oxullo/mml/eagle/production_files/revision_a/mml_matrix v14_top_bom.csv

Comment | Designator | Footprint | LCSC Part #
WS2812B-2020 | U101 U102 U103 U104 U105 U106 U107 U108 U109 U110 U111 U112 U113 U114 U115 U116 U117 U118 U119 U120 U121 U122 U123 U124 U125 U126 U127 U128 U129 U130 U131 U132 U133 U134 U135 U136 U137 U138 U139 U140 U141 U142 U143 U144 U145 U146 U147 U148 U149 U150 U151 U152 U153 U154 U155 U156 U157 U158 U159 U160 U161 U162 U163 U164 | RESCAV100P200X220X28-4L
