oxullo/mml/eagle/production_files/revision_b/mml_mcu_brd.pdf

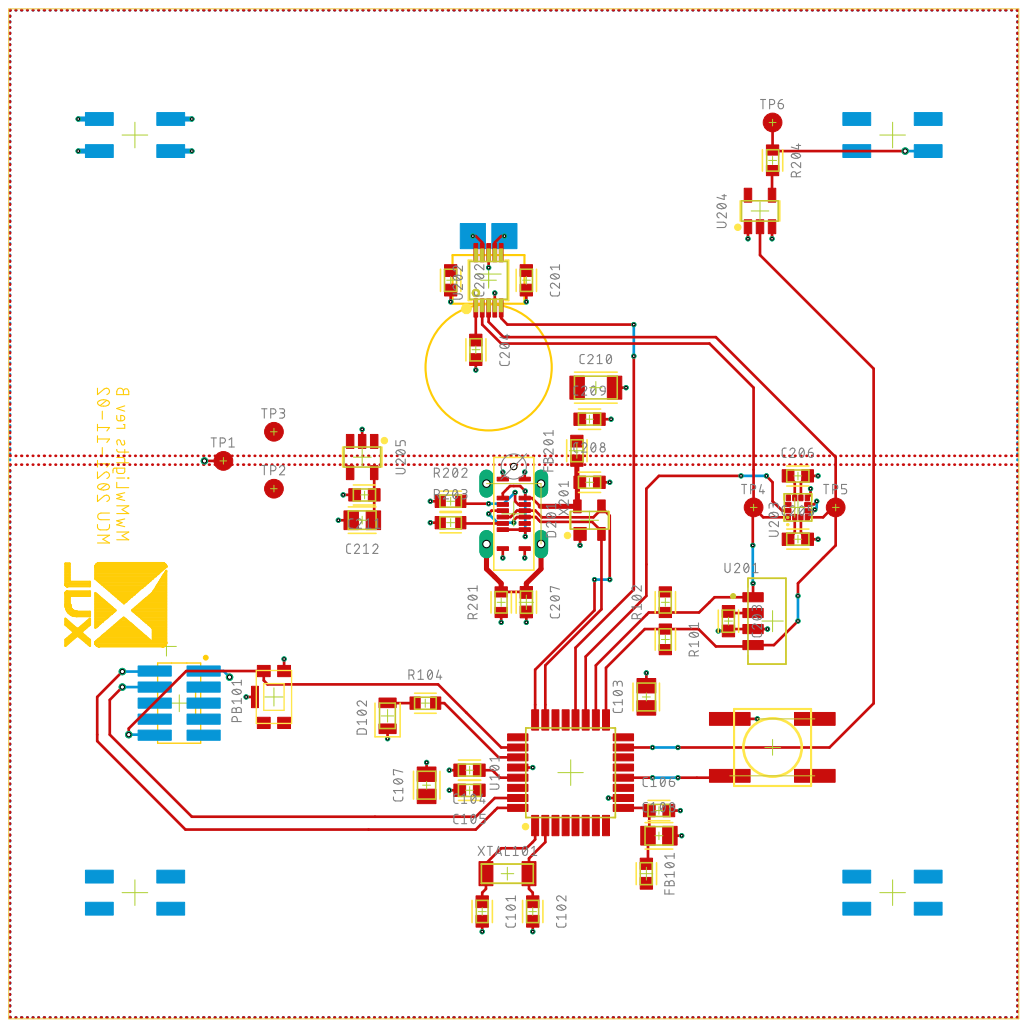
[picture p1: page 1]
