oxullo/mml/eagle/production_files/revision_b/mml_mcu_sch.pdf

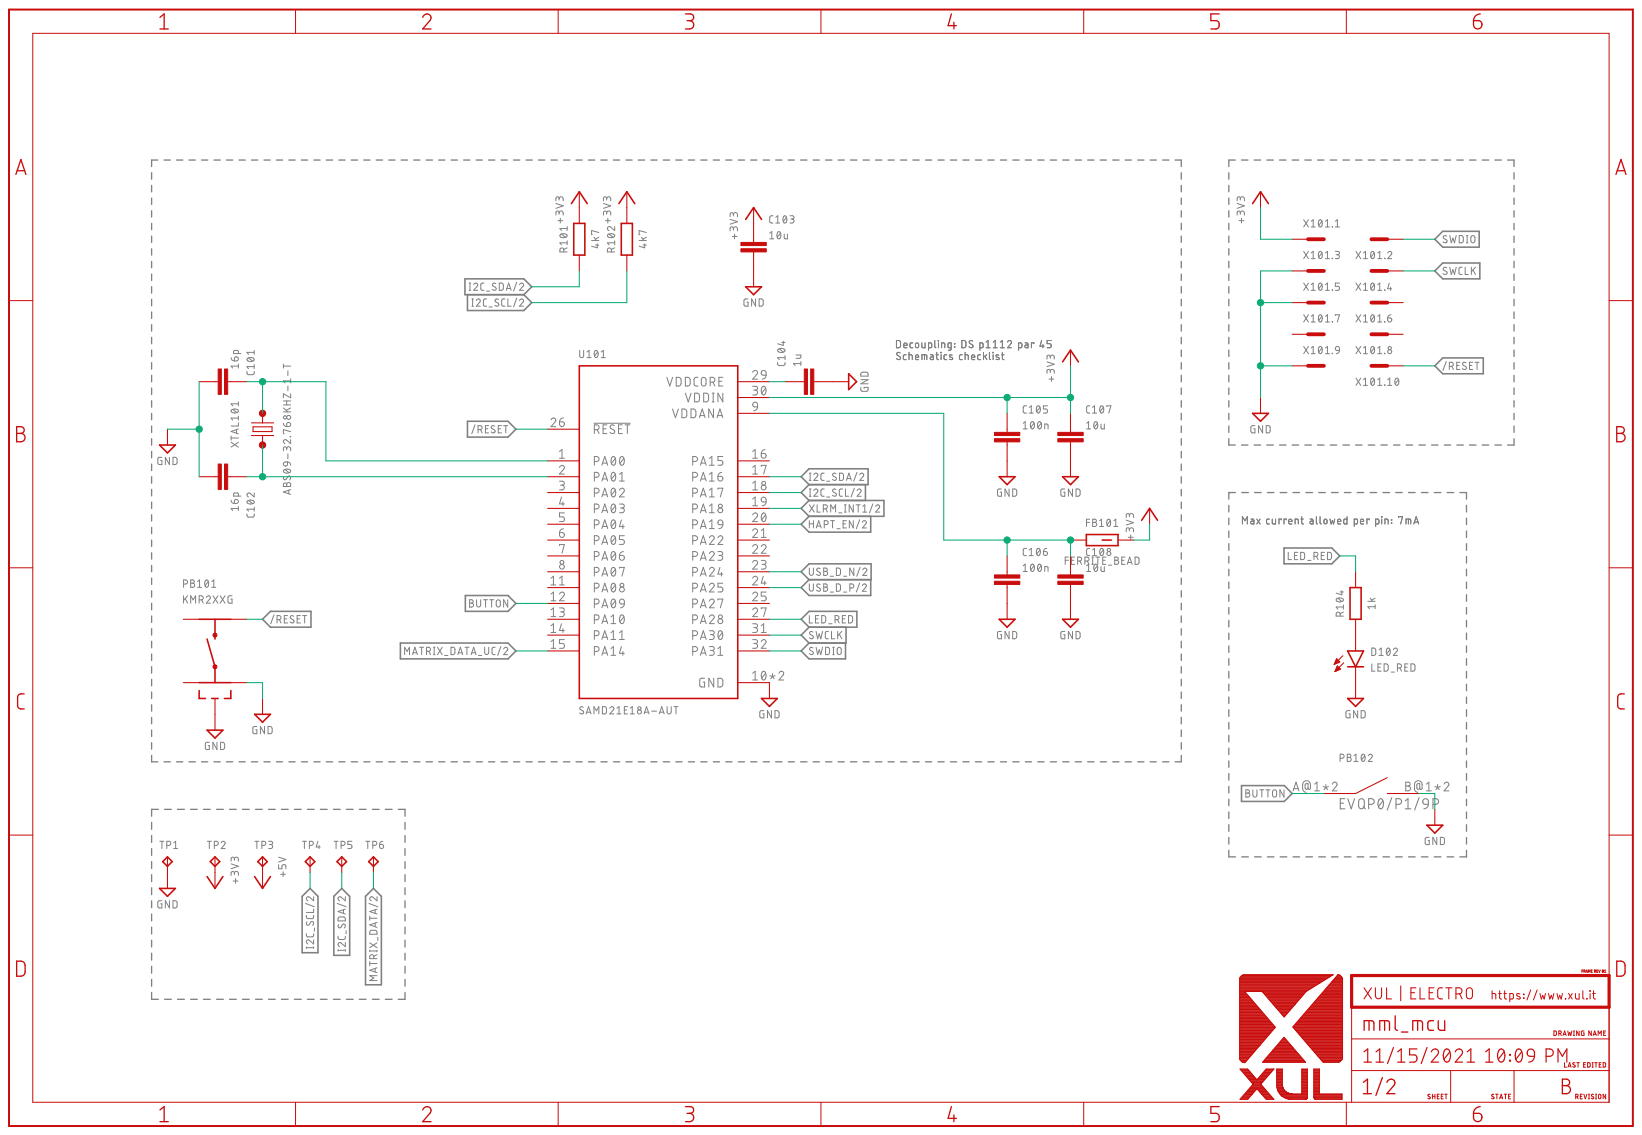
[picture p2: page 1]

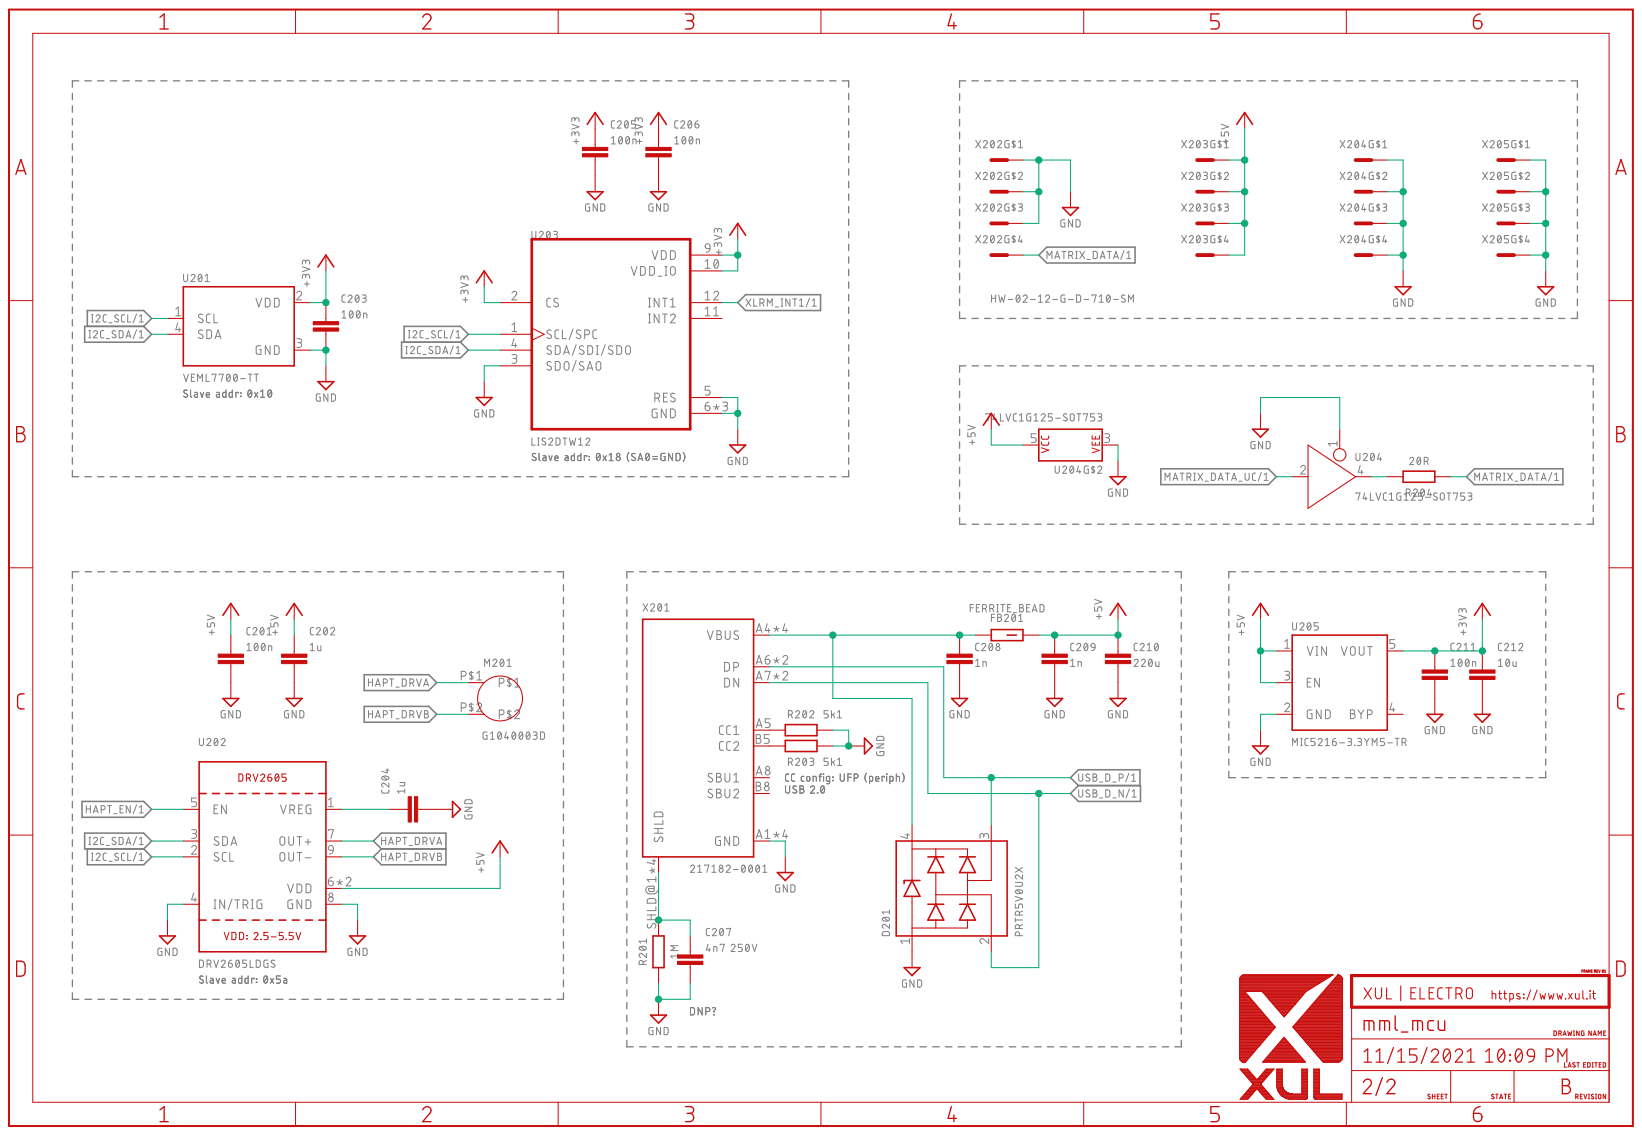
[picture p3: page 2]
