oxullo/mml/eagle/production_files/revision_a/mml_matrix_brd.pdf

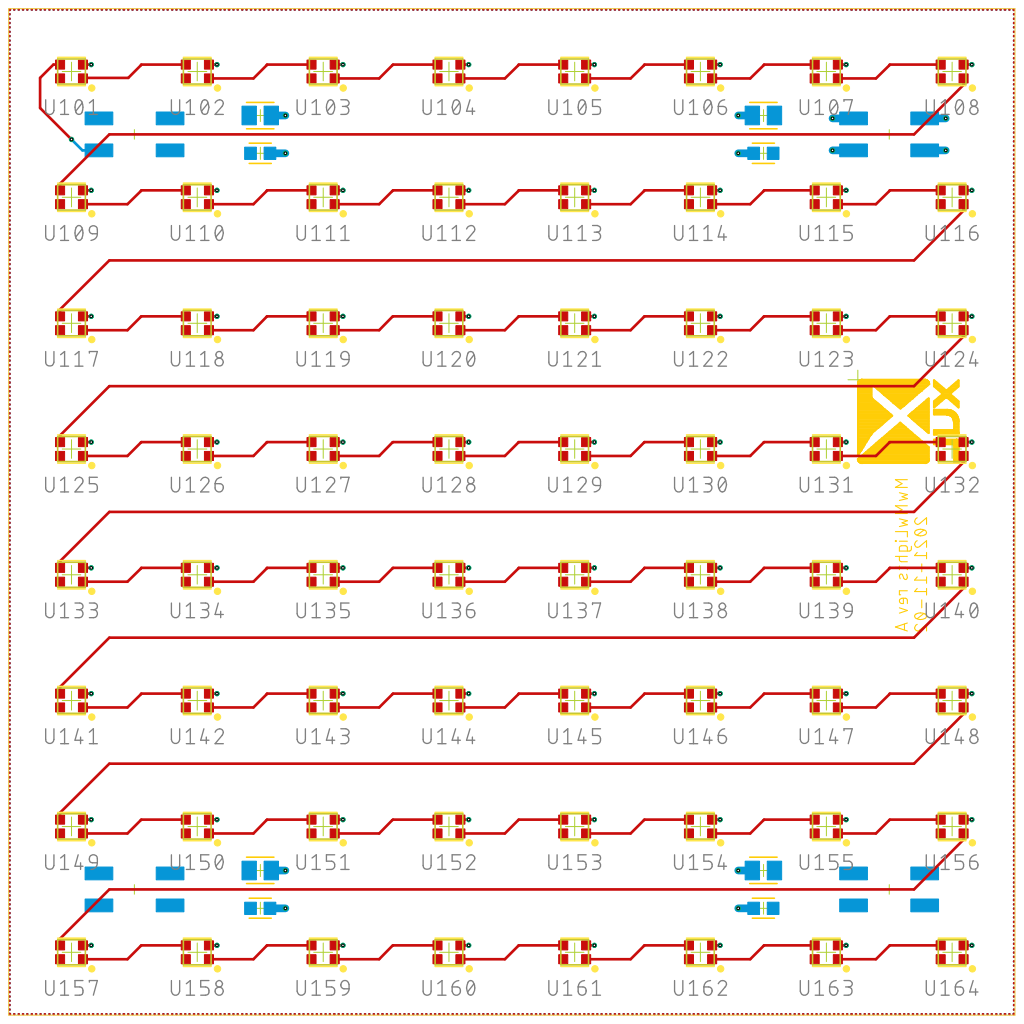
[picture p4: page 1]
