oxullo/mml/eagle/production_files/revision_a/mml_matrix_sch.pdf

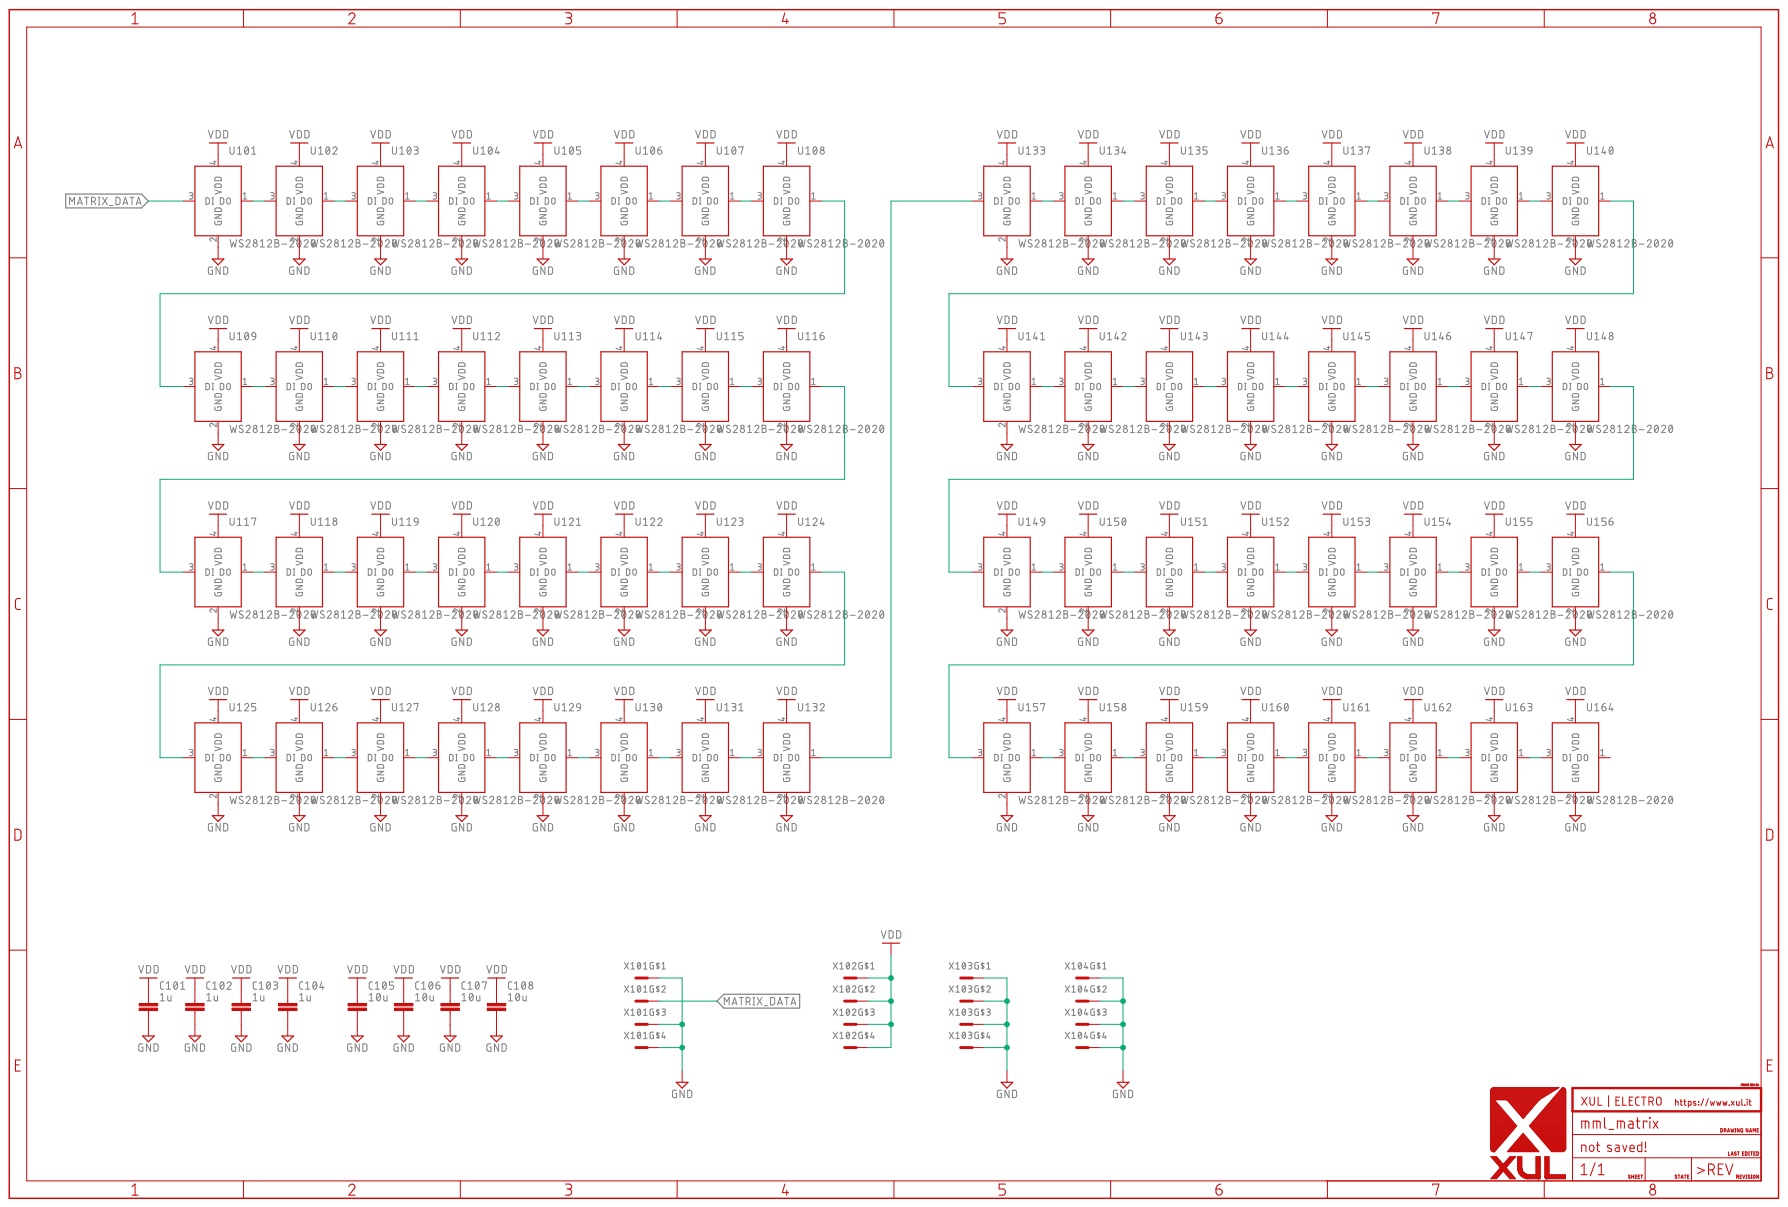
[picture p5: page 1]
