oxullo/mml/eagle/production_files/revision_a/mml_mcu_brd.pdf

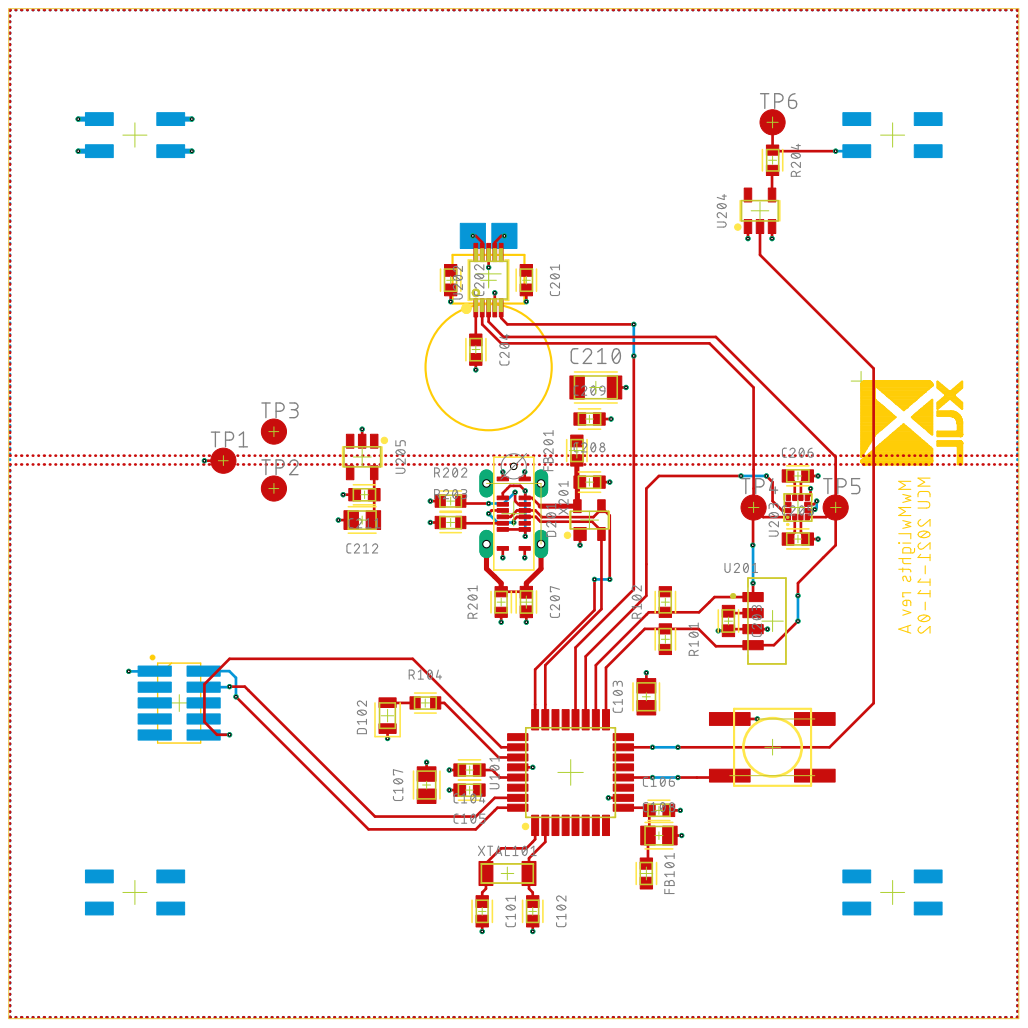
[picture p6: page 1]
