oxullo/mml/eagle/production_files/revision_a/mml_mcu_sch.pdf

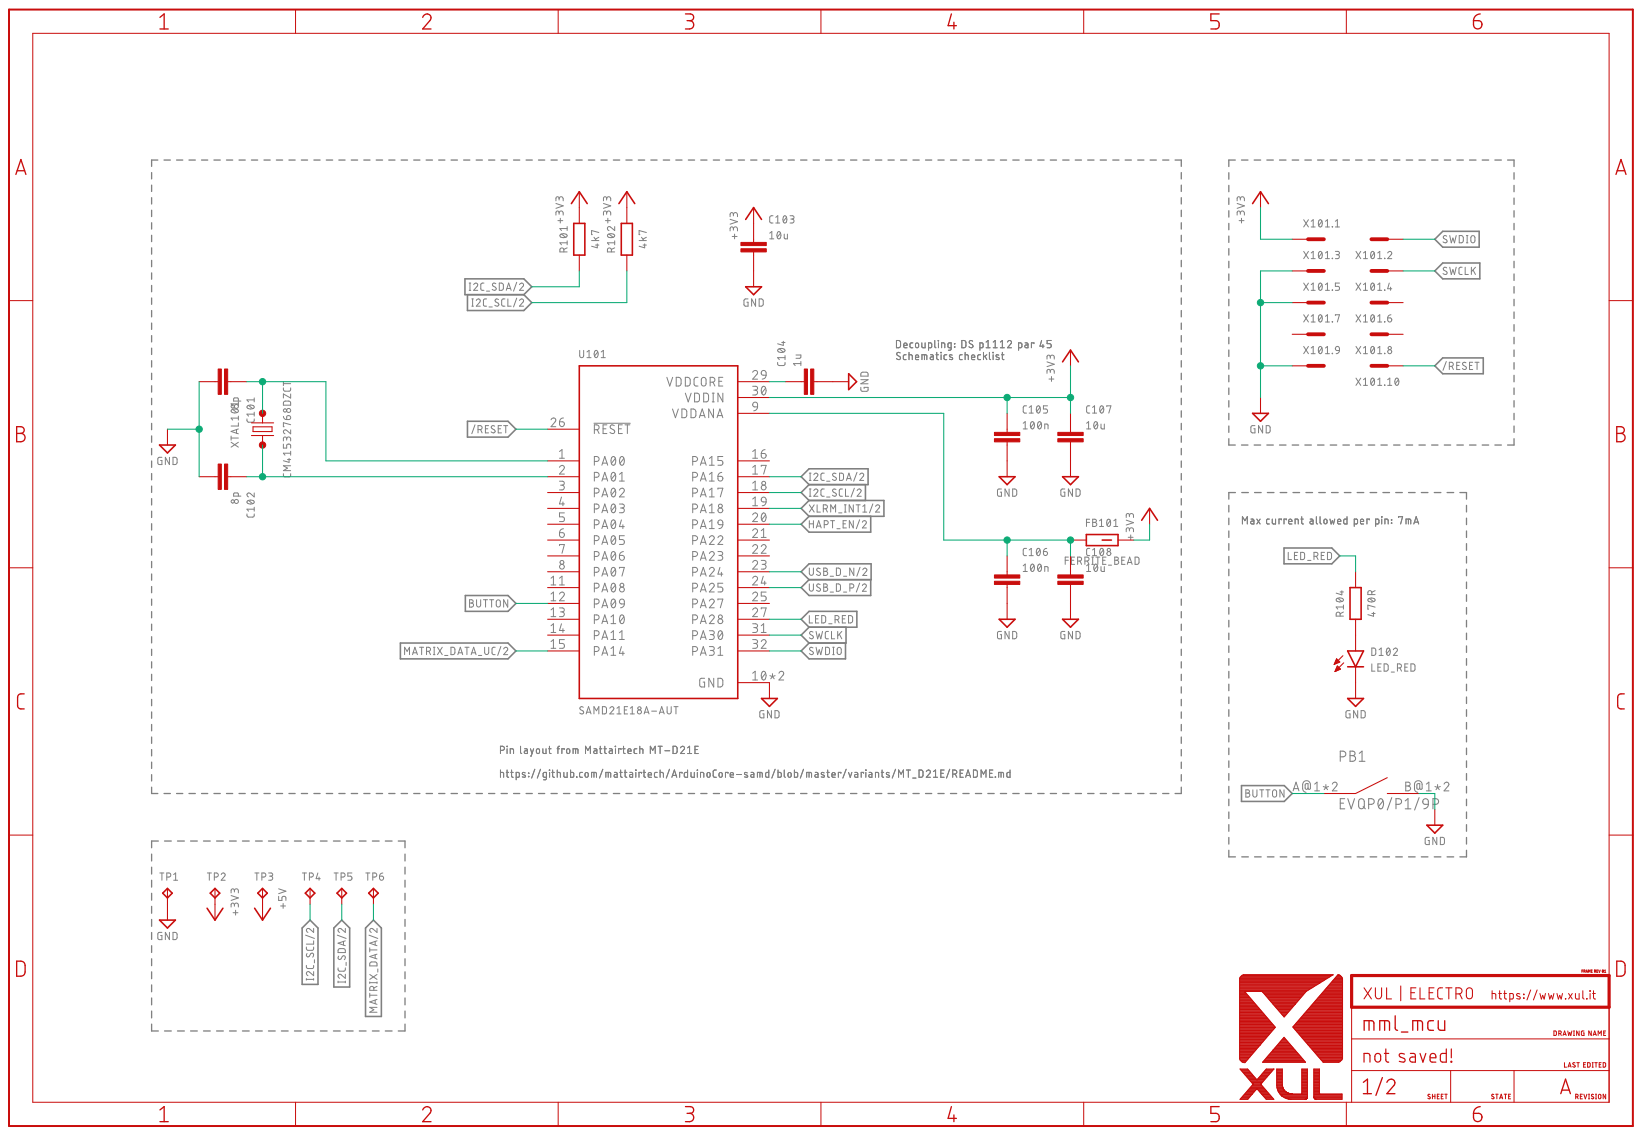
[picture p7: page 1]

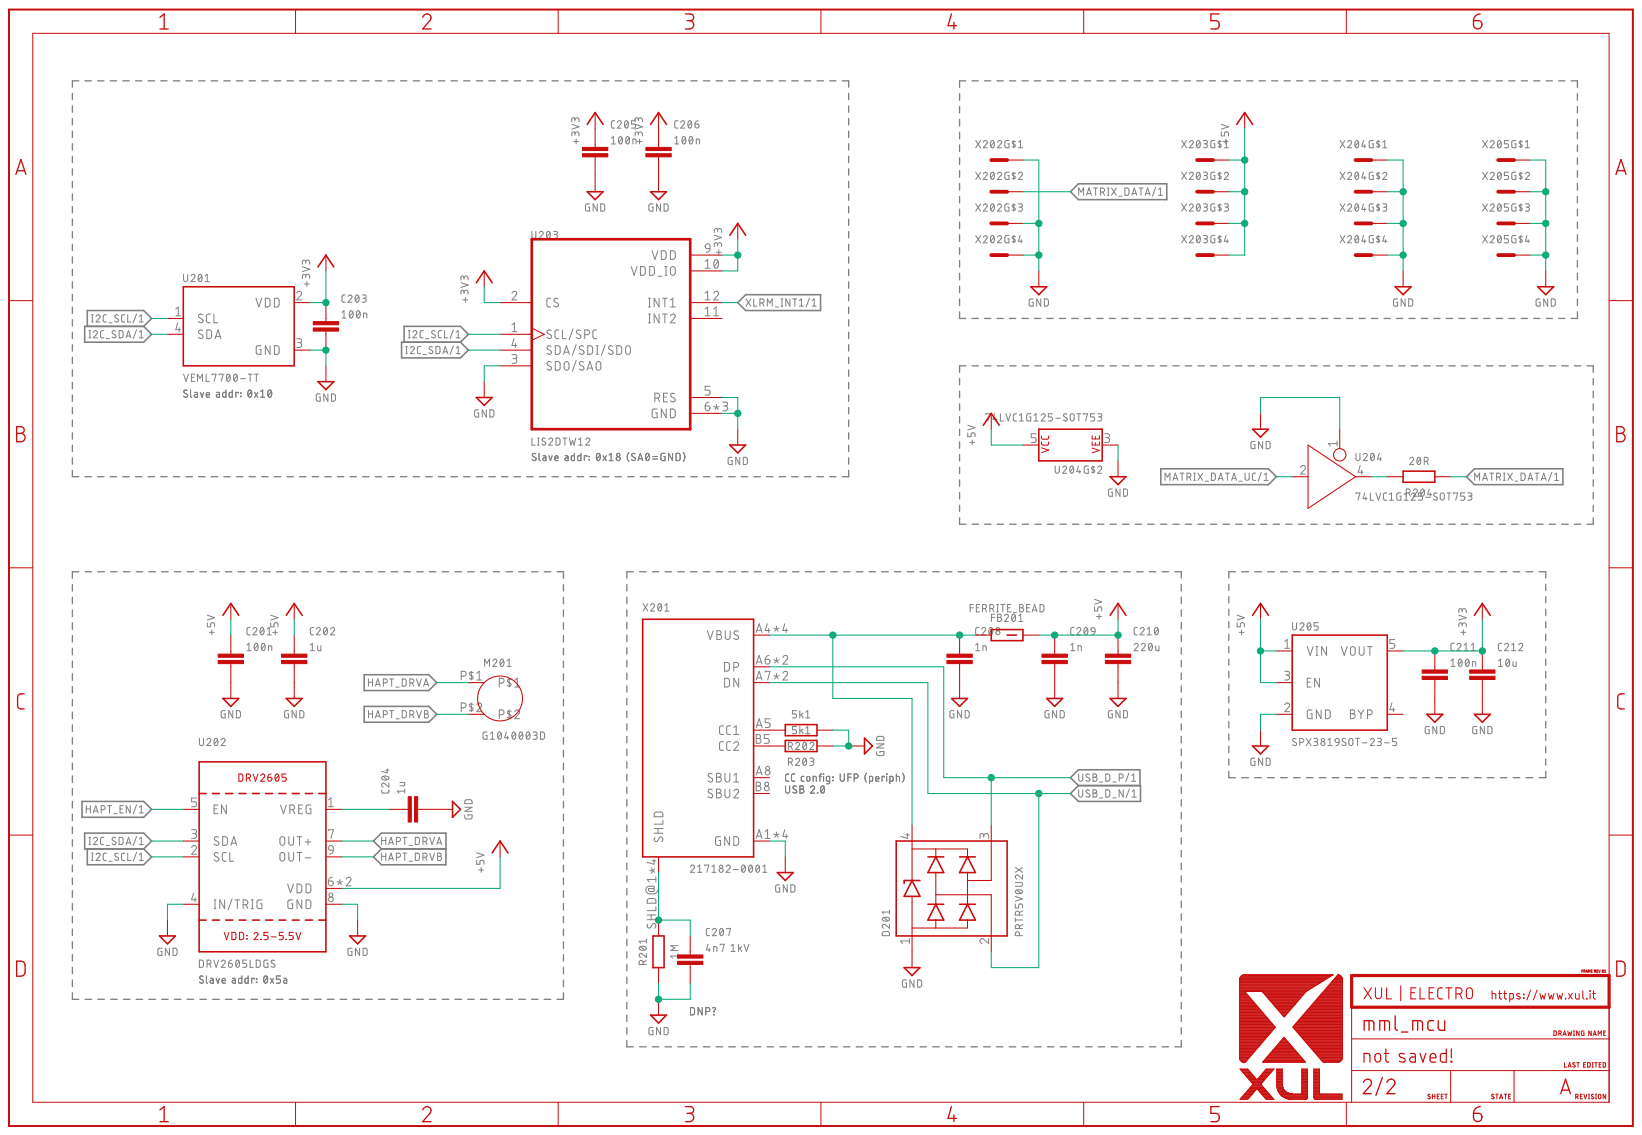
[picture p8: page 2]
