oxullo/mml/eagle/mml_mcu.brd

## EAGLE design eagle/mml_mcu.brd (2021-11-15)

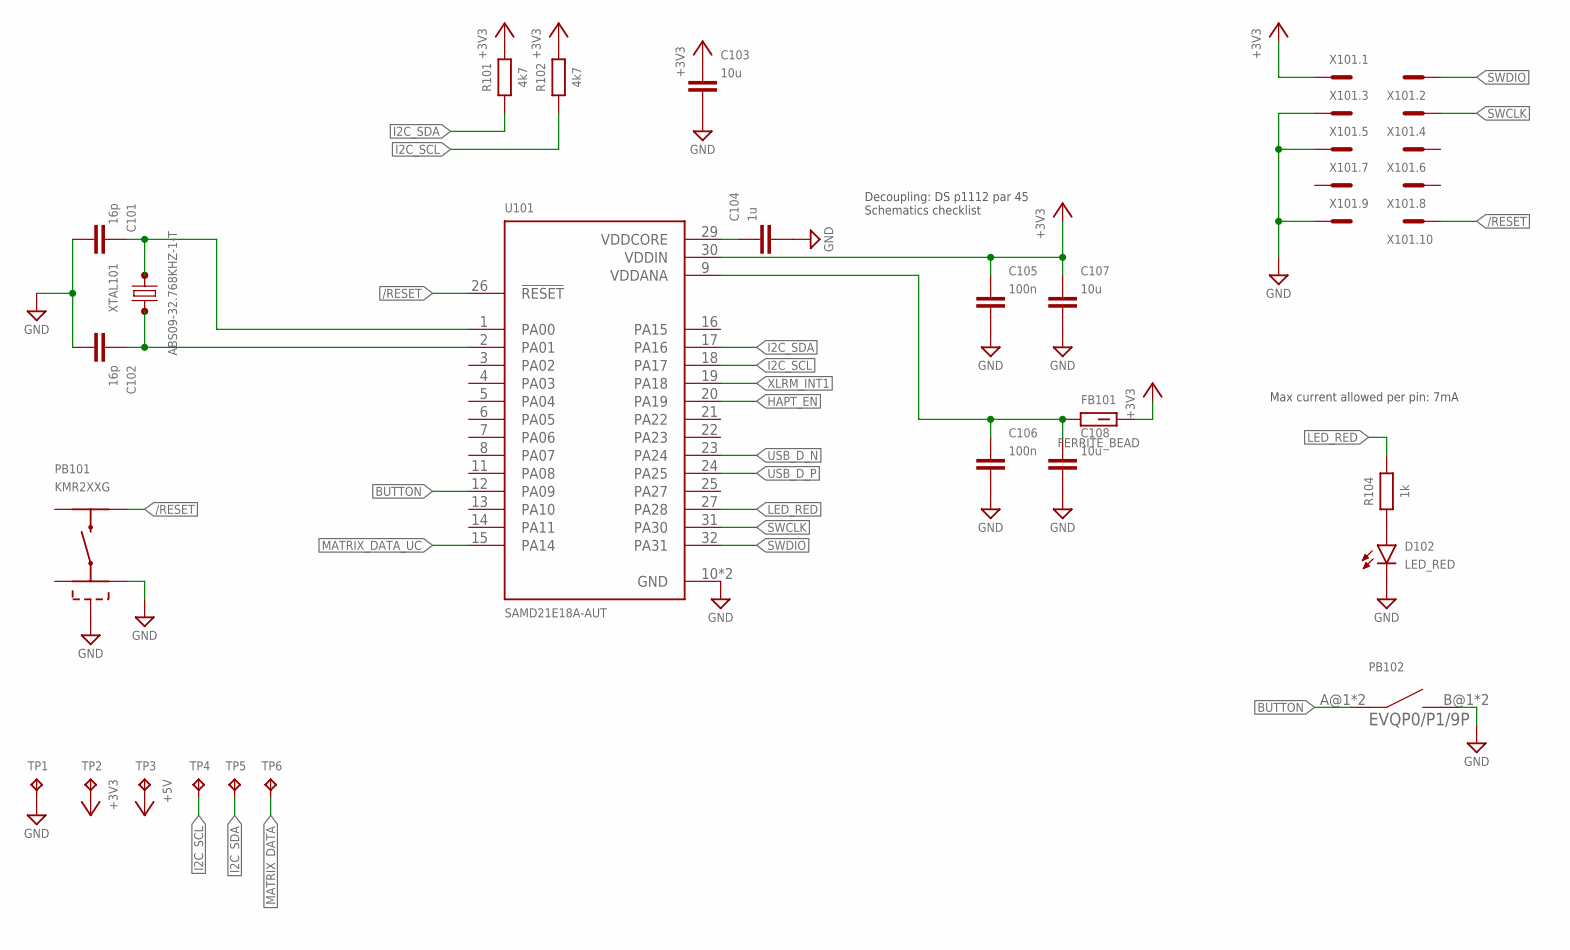
[picture p9: schematic mml_mcu.sch, sheet 1]

Parts:
C101, C102: 16p; CAPC1608X85
C103, C107, C108: 10u; CAPC2012X110
C104: 1u; CAPC1608X85
C105, C106: 100n; CAPC1608X85
D102: LED_RED; LEDC2012X110N_FLAT-R
FB101: FERRITE_BEAD; BEADC1608X95N
PB101: KMR2XXG
PB102: EVQP0/P1/9P
R101, R102: 4k7; RESC1608X60
R104: 1k; RESC1608X60
TP1, TP2, TP3, TP4, TP5, TP6: TPTP15R; TP15R
U101: SAMD21E18A-AUT; QFP80P900X900X120-32N
X101: M50-3600542R
XTAL101: ABS09-32.768KHZ-1-T; XTAL410X150X90

Connections:
+3V3: C103.1, C105.1, C107.1, FB101.2, R101.2, R102.2, TP2.TP, U101.30 (VDDIN), X101.1; also elsewhere on the board
+5V: TP3.TP; also elsewhere on the board
/RESET: PB101.1, U101.26 (!RESET), X101.10
BUTTON: PB102.A@1 (A), PB102.A@2 (A), U101.12 (PA09)
GND: C101.2, C102.2, C103.2, C104.2, C105.2, C106.2, C107.2, C108.2, D102.C, PB101.2, PB101.5, PB102.B@1 (B), PB102.B@2 (B), TP1.TP, U101.10 (GND), U101.28 (GND), X101.3, X101.5, X101.9; also elsewhere on the board
HAPT_EN: U101.20 (PA19); also elsewhere on the board
I2C_SCL: R102.1, TP4.TP, U101.18 (PA17); also elsewhere on the board
I2C_SDA: R101.1, TP5.TP, U101.17 (PA16); also elsewhere on the board
LED_RED: R104.2, U101.27 (PA28)
MATRIX_DATA: TP6.TP; also elsewhere on the board
MATRIX_DATA_UC: U101.15 (PA14); also elsewhere on the board
unnamed: C101.1, U101.1 (PA00), XTAL101.1 (A)
unnamed: C102.1, U101.2 (PA01), XTAL101.2 (B)
unnamed: C104.1, U101.29 (VDDCORE)
unnamed: D102.A, R104.1
unnamed: C106.1, C108.1, FB101.1, U101.9 (VDDANA)
SWCLK: U101.31 (PA30), X101.4
SWDIO: U101.32 (PA31), X101.2
USB_D_N: U101.23 (PA24); also elsewhere on the board
USB_D_P: U101.24 (PA25); also elsewhere on the board
XLRM_INT1: U101.19 (PA18); also elsewhere on the board

Notes on the sheet:
Decoupling: DS p1112 par 45 Schematics checklist
Max current allowed per pin: 7mA

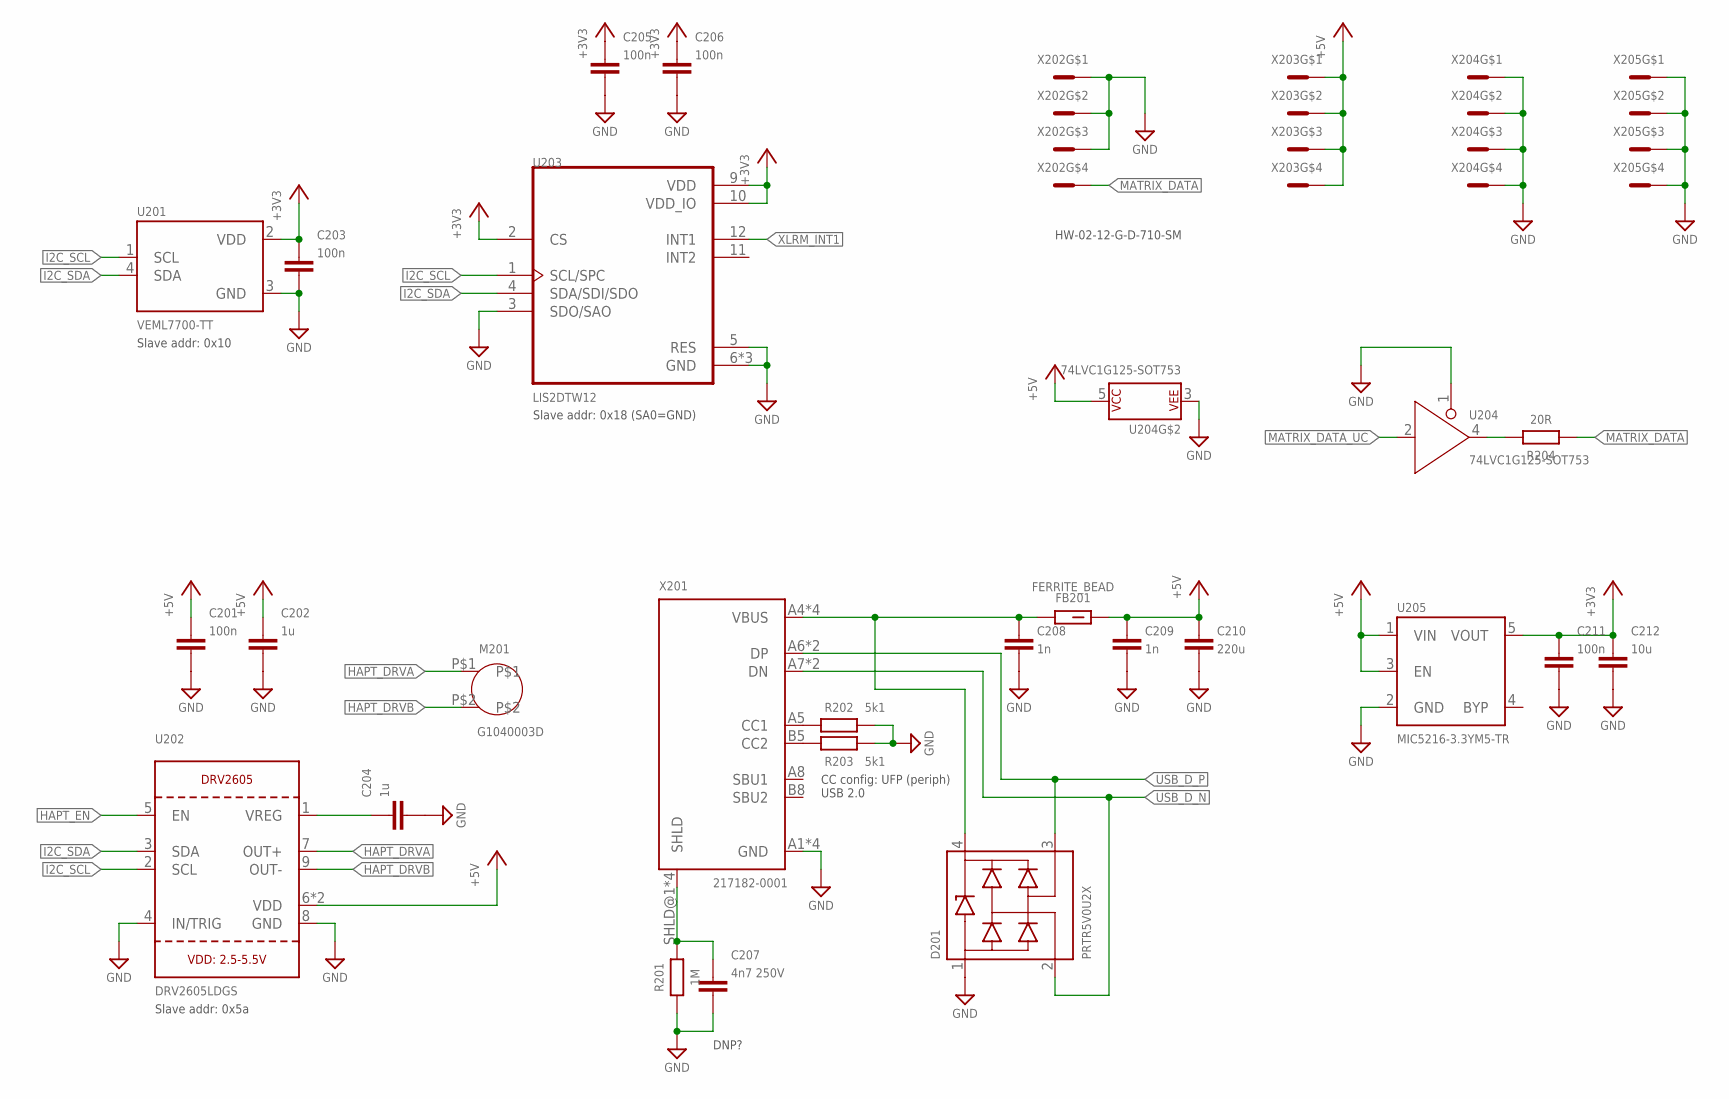
[picture p10: schematic mml_mcu.sch, sheet 2]

Parts:
C201, C203, C205, C206, C211: 100n; CAPC1608X85
C202, C204: 1u; CAPC1608X85
C207: 4n7 250V; CAPC1608X85
C208, C209: 1n; CAPC1608X85
C210: 220u; CAPC3216X135
C212: 10u; CAPC2012X110
D201: PRTR5V0U2X; SOT190P230X110-4N
FB201: FERRITE_BEAD; BEADC1608X95N
M201: G1040003D
R201: 1M; RESC1608X60
R202, R203: 5k1; RESC1608X60
R204: 20R; RESC1608X60
U201: VEML7700-TT; XDCR_VEML7700-TT
U202: DRV2605LDGS; PSOP10; LCSC_PART C527464
U203: LIS2DTW12; PQFN50P200X200100-12N; LCSC_PART C110926
U204: 74LVC1G125-SOT753; SOT95P280X145-5N
U205: MIC5216-3.3YM5-TR; SOT95P280X145-5N
X201: 217182-0001
X202, X203, X204, X205: HW-02-10-T-D-500-SM

Connections:
+3V3: C203.1, C205.1, C206.1, C211.1, C212.1, U201.2 (VDD), U203.2 (CS), U203.9 (VDD), U203.10 (VDD_IO), U205.5 (VOUT); also elsewhere on the board
+5V: C201.1, C202.1, C209.1, C210.1, FB201.2, U202.6 (VDD), U202.10 (VDD), U204.5 (P$V+), U205.1 (VIN), U205.3 (EN), X203.P$1, X203.P$2, X203.P$3, X203.P$4; also elsewhere on the board
GND: C201.2, C202.2, C203.2, C204.2, C205.2, C206.2, C207.2, C208.2, C209.2, C210.2, C211.2, C212.2, D201.1, R201.1, R202.1, R203.1, U201.3 (GND), U202.4 (IN/TRIG), U202.8 (GND), U203.3 (SDO/SAO), U203.5 (RES), U203.6 (GND), U203.7 (GND), U203.8 (GND), U204.1 (/OE), U204.3 (P$V-), U205.2 (GND), X201.A1 (GND), X201.A12 (GND), X201.B1 (GND), X201.B12 (GND), X202.P$1, X202.P$2, X202.P$3, X204.P$1, X204.P$2, X204.P$3, X204.P$4, X205.P$1, X205.P$2, X205.P$3, X205.P$4; also elsewhere on the board
HAPT_DRVA: M201.P$1, U202.7 (OUT+)
HAPT_DRVB: M201.P$2, U202.9 (OUT-)
HAPT_EN: U202.5 (EN); also elsewhere on the board
I2C_SCL: U201.1 (SCL), U202.2 (SCL), U203.1 (SCL/SPC); also elsewhere on the board
I2C_SDA: U201.4 (SDA), U202.3 (SDA), U203.4 (SDA/SDI/SDO); also elsewhere on the board
MATRIX_DATA: R204.1, X202.P$4; also elsewhere on the board
MATRIX_DATA_UC: U204.2 (A); also elsewhere on the board
unnamed: C204.1, U202.1 (VREG)
unnamed: C207.1, R201.2, X201.SHLD@1 (SHLD), X201.SHLD@2 (SHLD), X201.SHLD@3 (SHLD), X201.SHLD@4 (SHLD)
unnamed: C208.1, D201.4, FB201.1, X201.A4 (VBUS), X201.A9 (VBUS), X201.B4 (VBUS), X201.B9 (VBUS)
unnamed: R204.2, U204.4 (Y)
unnamed: R202.2, X201.A5 (CC1)
unnamed: R203.2, X201.B5 (CC2)
USB_D_N: D201.2, X201.A7 (DN), X201.B7 (DN); also elsewhere on the board
USB_D_P: D201.3, X201.A6 (DP), X201.B6 (DP); also elsewhere on the board
XLRM_INT1: U203.12 (INT1); also elsewhere on the board

Notes on the sheet:
Slave addr: 0x18 (SA0=GND)
Slave addr: 0x10
Slave addr: 0x5a
DNP?
CC config: UFP (periph) USB 2.0
HW-02-12-G-D-710-SM

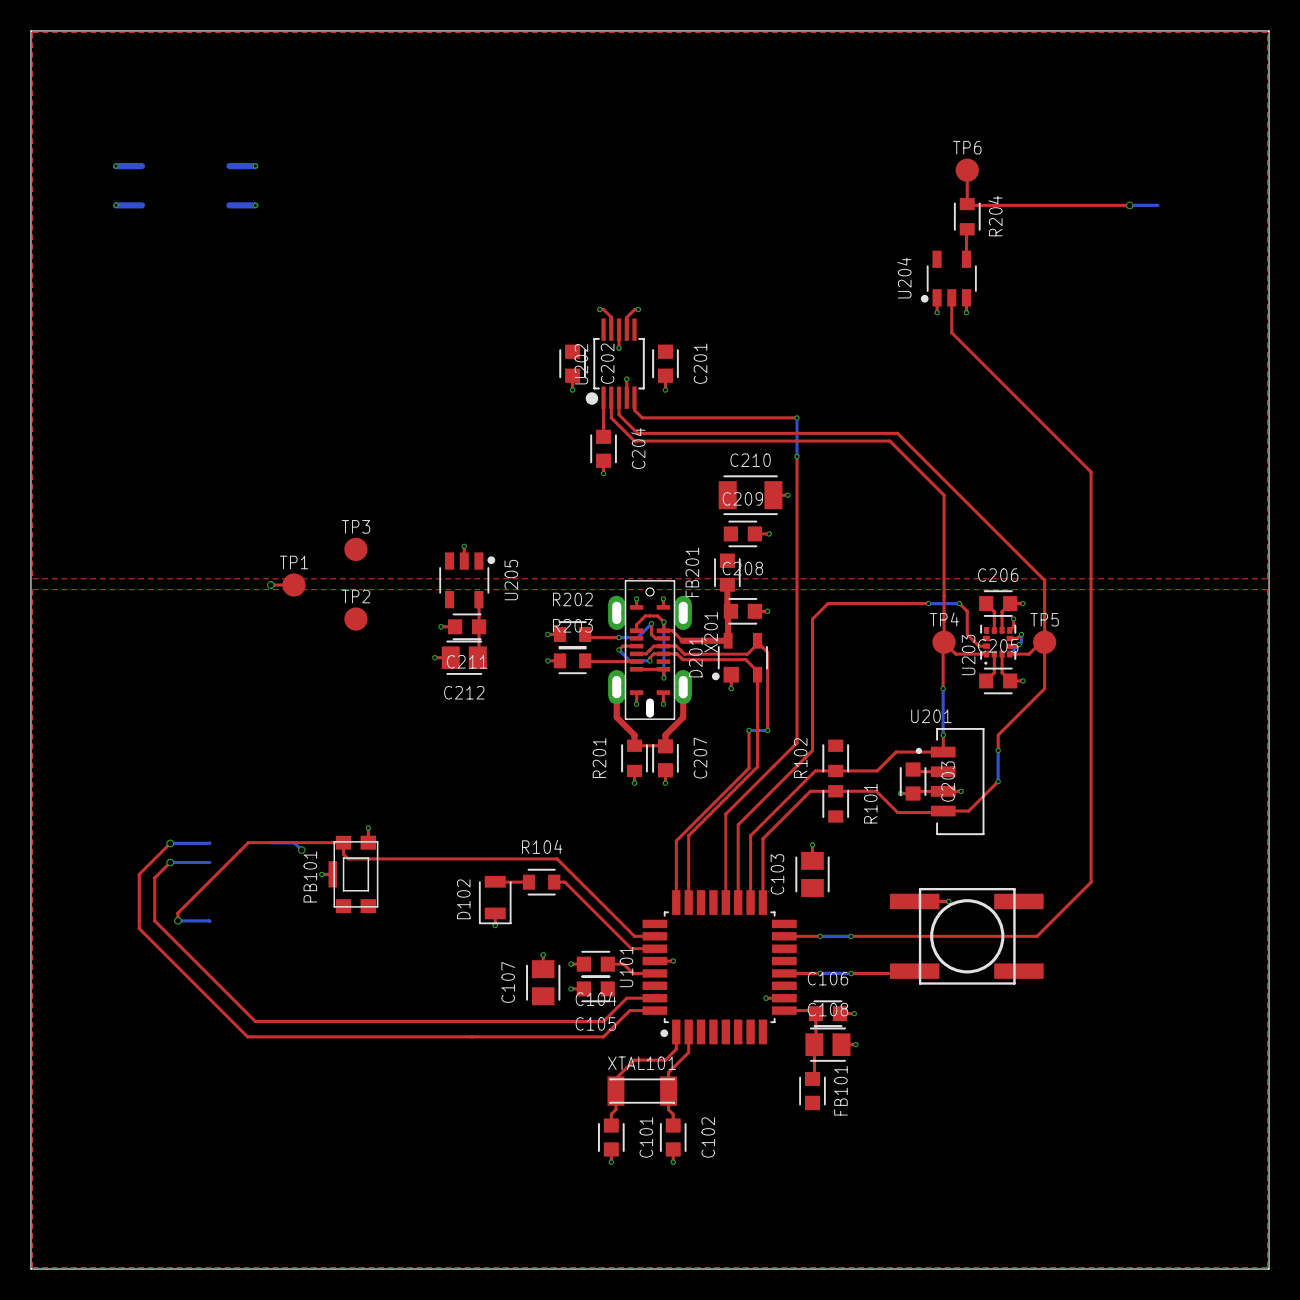
[picture p11: board mml_mcu.brd from above]

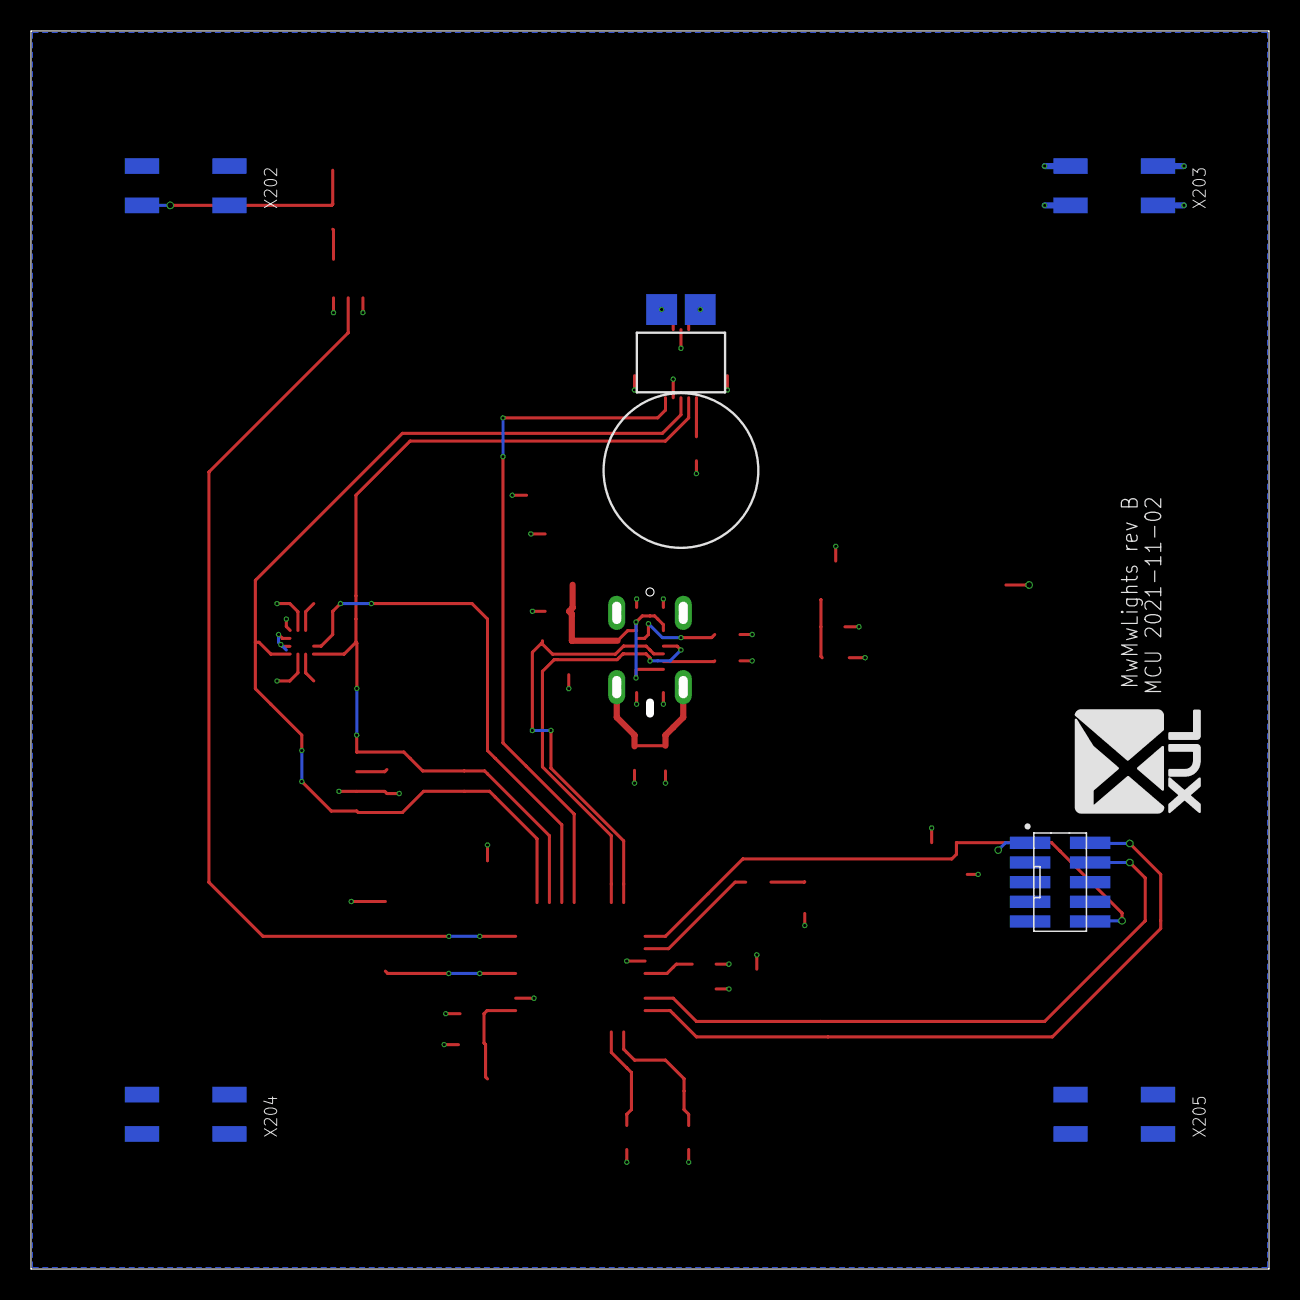
[picture p12: board mml_mcu.brd from below]

Board: 2 copper layers, 80.0 x 80.0 mm, 54 parts (7 on the bottom side), 29 nets.

Other parts of the board:
U$1: XUL-LOGO-8MMH
