oxullo/mml/eagle/mml_matrix.brd

## EAGLE design eagle/mml_matrix.brd (2021-10-18)

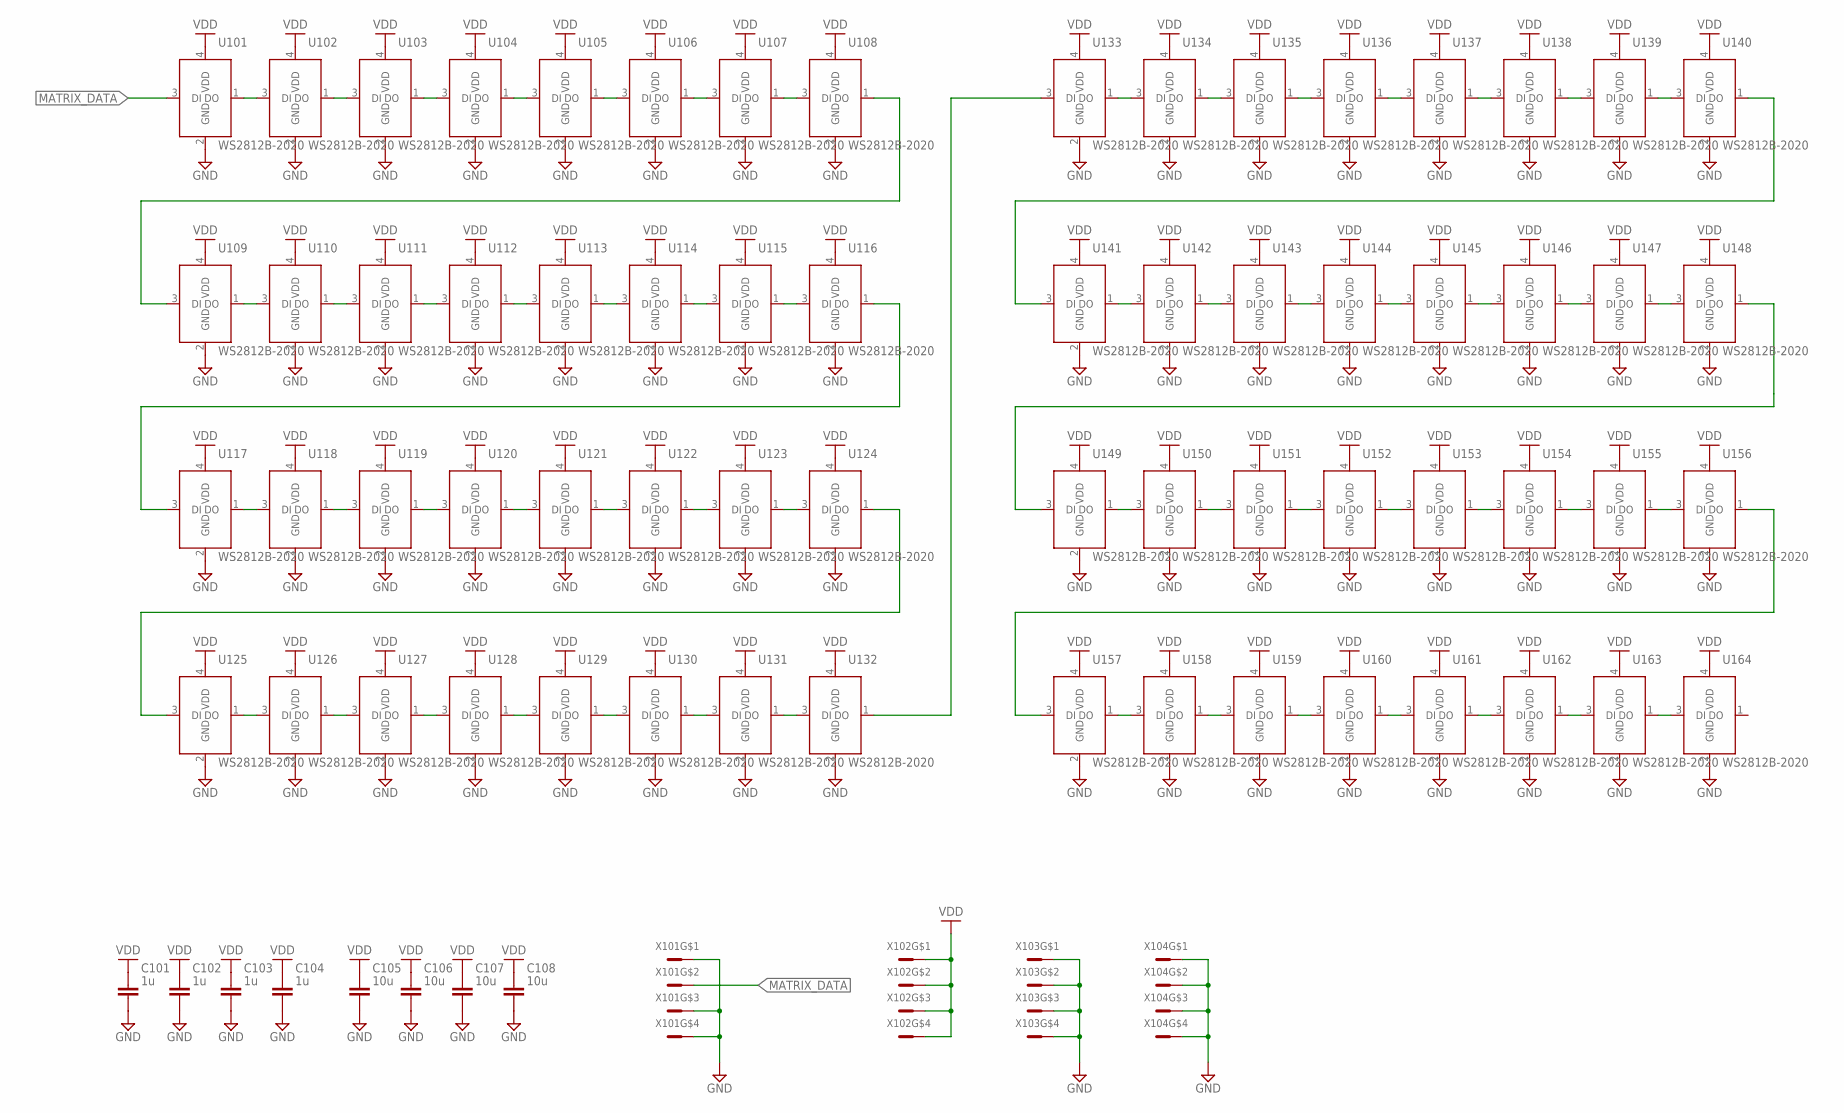
[picture p13: schematic mml_matrix.sch]

Parts:
C101, C102, C103, C104: 1u; CAPC1608X85
C105, C106, C107, C108: 10u; CAPC2012X110
U101, U102, U103, U104, U105, U106, U107, U108, U109, U110, U111, U112, U113, U114, U115, U116, U117, U118, U119, U120, U121, U122, U123, U124, U125, U126, U127, U128, U129, U130, U131, U132, U133, U134, U135, U136, U137, U138, U139, U140, U141, U142, U143, U144, U145, U146, U147, U148, U149, U150, U151, U152, U153, U154, U155, U156, U157, U158, U159, U160, U161, U162, U163, U164: WS2812B-2020; RESCAV100P200X220X28-4L
X101, X102, X103, X104: HW-02-10-T-D-500-SM

Connections:
GND: C101.2, C102.2, C103.2, C104.2, C105.2, C106.2, C107.2, C108.2, U101.2 (GND), U102.2 (GND), U103.2 (GND), U104.2 (GND), U105.2 (GND), U106.2 (GND), U107.2 (GND), U108.2 (GND), U109.2 (GND), U110.2 (GND), U111.2 (GND), U112.2 (GND), U113.2 (GND), U114.2 (GND), U115.2 (GND), U116.2 (GND), U117.2 (GND), U118.2 (GND), U119.2 (GND), U120.2 (GND), U121.2 (GND), U122.2 (GND), U123.2 (GND), U124.2 (GND), U125.2 (GND), U126.2 (GND), U127.2 (GND), U128.2 (GND), U129.2 (GND), U130.2 (GND), U131.2 (GND), U132.2 (GND), U133.2 (GND), U134.2 (GND), U135.2 (GND), U136.2 (GND), U137.2 (GND), U138.2 (GND), U139.2 (GND), U140.2 (GND), U141.2 (GND), U142.2 (GND), U143.2 (GND), U144.2 (GND), U145.2 (GND), U146.2 (GND), U147.2 (GND), U148.2 (GND), U149.2 (GND), U150.2 (GND), U151.2 (GND), U152.2 (GND), U153.2 (GND), U154.2 (GND), U155.2 (GND), U156.2 (GND), U157.2 (GND), U158.2 (GND), U159.2 (GND), U160.2 (GND), U161.2 (GND), U162.2 (GND), U163.2 (GND), U164.2 (GND), X101.P$1, X101.P$3, X101.P$4, X103.P$1, X103.P$2, X103.P$3, X103.P$4, X104.P$1, X104.P$2, X104.P$3, X104.P$4
MATRIX_DATA: U101.3 (DI), X101.P$2
unnamed: U101.1 (DO), U102.3 (DI)
unnamed: U102.1 (DO), U103.3 (DI)
unnamed: U103.1 (DO), U104.3 (DI)
unnamed: U104.1 (DO), U105.3 (DI)
unnamed: U105.1 (DO), U106.3 (DI)
unnamed: U106.1 (DO), U107.3 (DI)
unnamed: U107.1 (DO), U108.3 (DI)
unnamed: U117.1 (DO), U118.3 (DI)
unnamed: U118.1 (DO), U119.3 (DI)
unnamed: U119.1 (DO), U120.3 (DI)
unnamed: U120.1 (DO), U121.3 (DI)
unnamed: U121.1 (DO), U122.3 (DI)
unnamed: U122.1 (DO), U123.3 (DI)
unnamed: U123.1 (DO), U124.3 (DI)
unnamed: U133.1 (DO), U134.3 (DI)
unnamed: U134.1 (DO), U135.3 (DI)
unnamed: U135.1 (DO), U136.3 (DI)
unnamed: U136.1 (DO), U137.3 (DI)
unnamed: U137.1 (DO), U138.3 (DI)
unnamed: U138.1 (DO), U139.3 (DI)
unnamed: U139.1 (DO), U140.3 (DI)
unnamed: U149.1 (DO), U150.3 (DI)
unnamed: U150.1 (DO), U151.3 (DI)
unnamed: U151.1 (DO), U152.3 (DI)
unnamed: U152.1 (DO), U153.3 (DI)
unnamed: U153.1 (DO), U154.3 (DI)
unnamed: U154.1 (DO), U155.3 (DI)
unnamed: U155.1 (DO), U156.3 (DI)
unnamed: U109.1 (DO), U110.3 (DI)
unnamed: U110.1 (DO), U111.3 (DI)
unnamed: U111.1 (DO), U112.3 (DI)
unnamed: U112.1 (DO), U113.3 (DI)
unnamed: U113.1 (DO), U114.3 (DI)
unnamed: U114.1 (DO), U115.3 (DI)
unnamed: U115.1 (DO), U116.3 (DI)
unnamed: U125.1 (DO), U126.3 (DI)
unnamed: U126.1 (DO), U127.3 (DI)
unnamed: U127.1 (DO), U128.3 (DI)
unnamed: U128.1 (DO), U129.3 (DI)
unnamed: U129.1 (DO), U130.3 (DI)
unnamed: U130.1 (DO), U131.3 (DI)
unnamed: U131.1 (DO), U132.3 (DI)
unnamed: U141.1 (DO), U142.3 (DI)
unnamed: U142.1 (DO), U143.3 (DI)
unnamed: U143.1 (DO), U144.3 (DI)
unnamed: U144.1 (DO), U145.3 (DI)
unnamed: U145.1 (DO), U146.3 (DI)
unnamed: U146.1 (DO), U147.3 (DI)
unnamed: U147.1 (DO), U148.3 (DI)
unnamed: U157.1 (DO), U158.3 (DI)
unnamed: U158.1 (DO), U159.3 (DI)
unnamed: U159.1 (DO), U160.3 (DI)
unnamed: U160.1 (DO), U161.3 (DI)
unnamed: U161.1 (DO), U162.3 (DI)
unnamed: U162.1 (DO), U163.3 (DI)
unnamed: U163.1 (DO), U164.3 (DI)
unnamed: U108.1 (DO), U109.3 (DI)
unnamed: U116.1 (DO), U117.3 (DI)
unnamed: U124.1 (DO), U125.3 (DI)
unnamed: U132.1 (DO), U133.3 (DI)
unnamed: U140.1 (DO), U141.3 (DI)
unnamed: U148.1 (DO), U149.3 (DI)
unnamed: U156.1 (DO), U157.3 (DI)
VDD: C101.1, C102.1, C103.1, C104.1, C105.1, C106.1, C107.1, C108.1, U101.4 (VDD), U102.4 (VDD), U103.4 (VDD), U104.4 (VDD), U105.4 (VDD), U106.4 (VDD), U107.4 (VDD), U108.4 (VDD), U109.4 (VDD), U110.4 (VDD), U111.4 (VDD), U112.4 (VDD), U113.4 (VDD), U114.4 (VDD), U115.4 (VDD), U116.4 (VDD), U117.4 (VDD), U118.4 (VDD), U119.4 (VDD), U120.4 (VDD), U121.4 (VDD), U122.4 (VDD), U123.4 (VDD), U124.4 (VDD), U125.4 (VDD), U126.4 (VDD), U127.4 (VDD), U128.4 (VDD), U129.4 (VDD), U130.4 (VDD), U131.4 (VDD), U132.4 (VDD), U133.4 (VDD), U134.4 (VDD), U135.4 (VDD), U136.4 (VDD), U137.4 (VDD), U138.4 (VDD), U139.4 (VDD), U140.4 (VDD), U141.4 (VDD), U142.4 (VDD), U143.4 (VDD), U144.4 (VDD), U145.4 (VDD), U146.4 (VDD), U147.4 (VDD), U148.4 (VDD), U149.4 (VDD), U150.4 (VDD), U151.4 (VDD), U152.4 (VDD), U153.4 (VDD), U154.4 (VDD), U155.4 (VDD), U156.4 (VDD), U157.4 (VDD), U158.4 (VDD), U159.4 (VDD), U160.4 (VDD), U161.4 (VDD), U162.4 (VDD), U163.4 (VDD), U164.4 (VDD), X102.P$1, X102.P$2, X102.P$3, X102.P$4

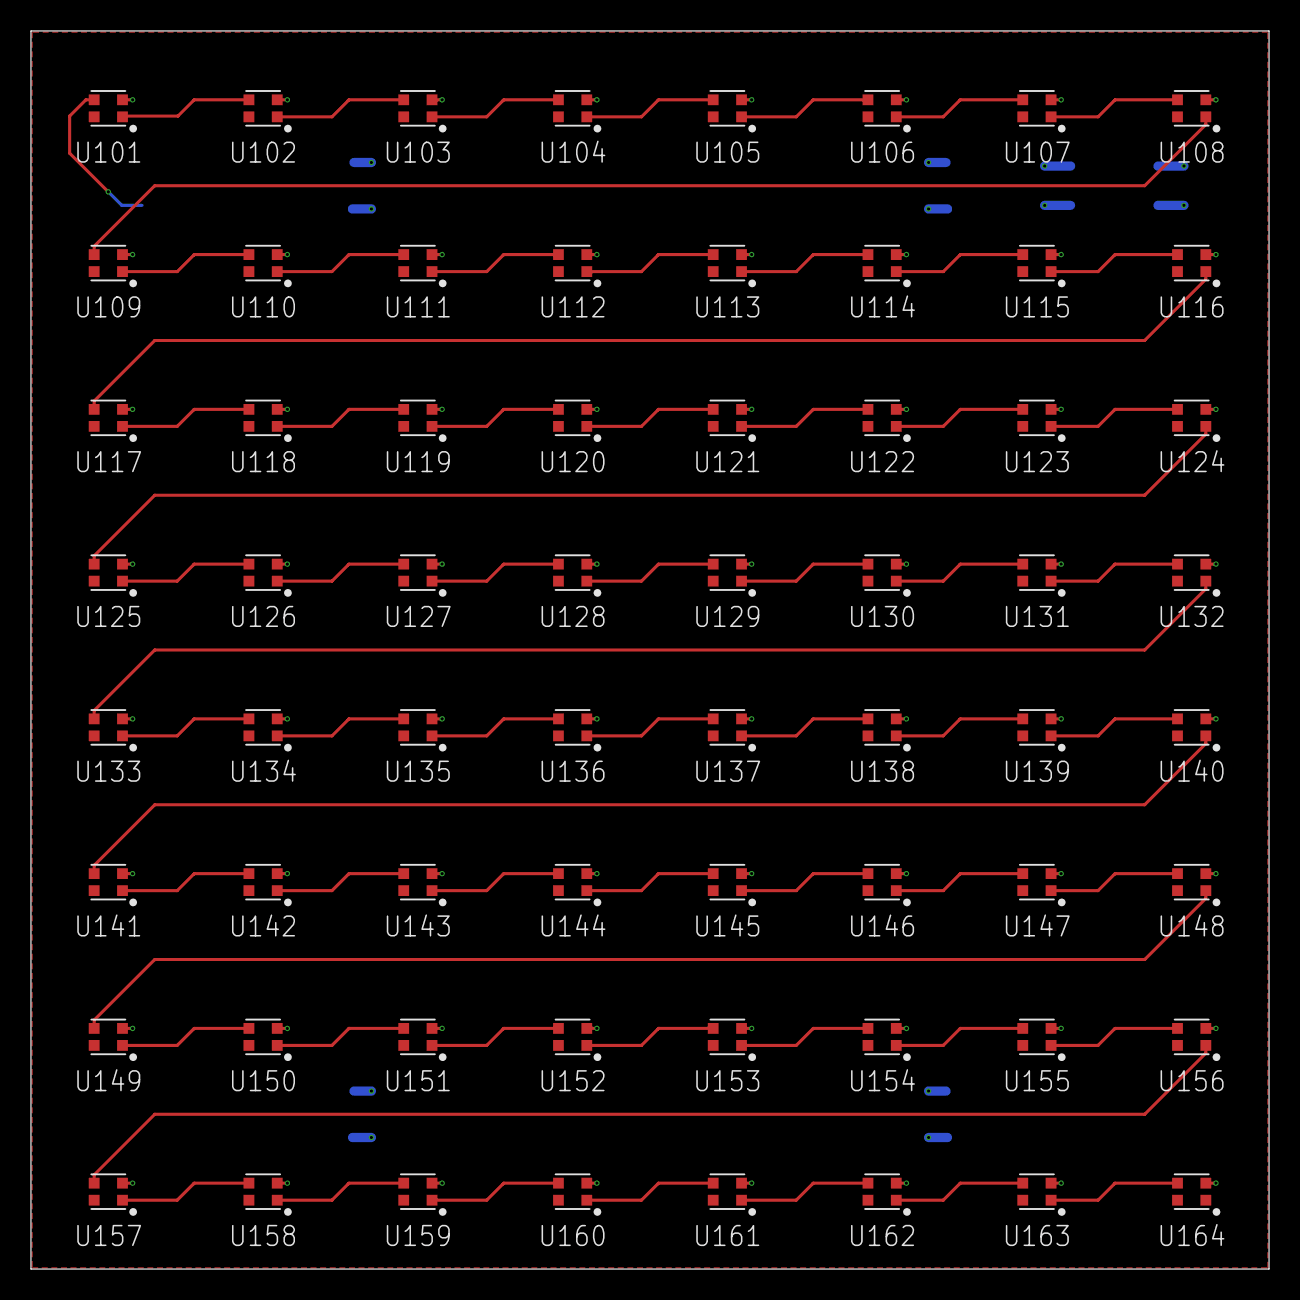
[picture p14: board mml_matrix.brd from above]

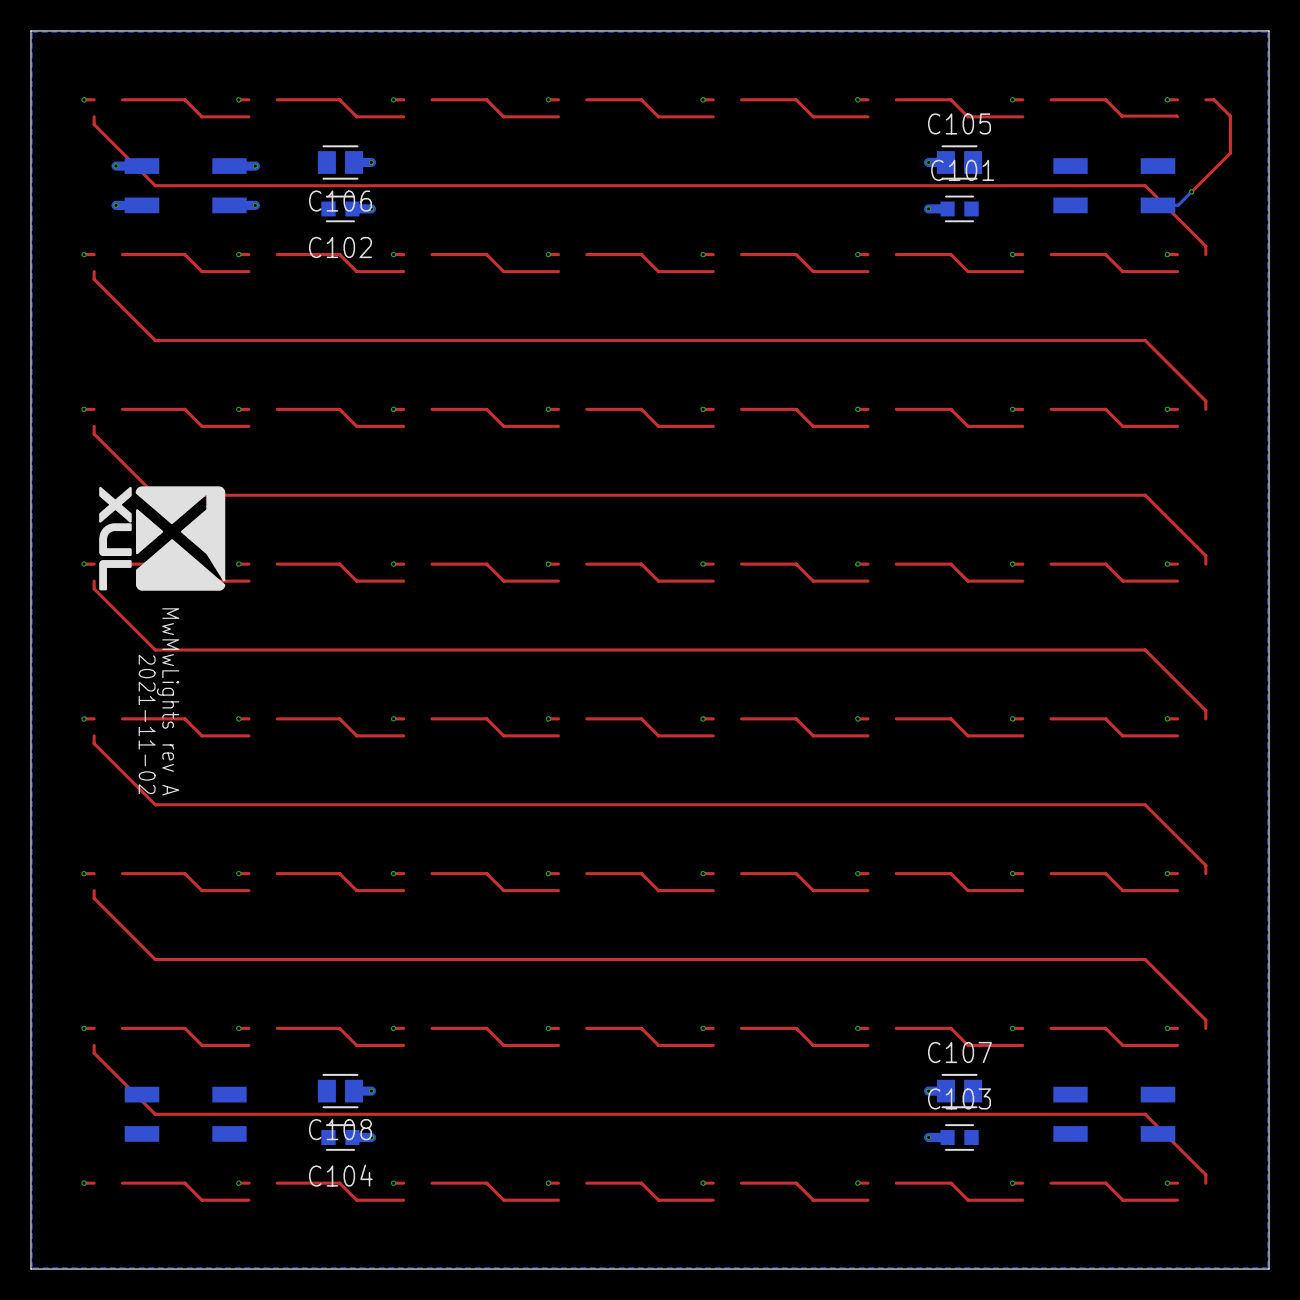
[picture p15: board mml_matrix.brd from below]

Board: 2 copper layers, 80.0 x 80.0 mm, 77 parts (13 on the bottom side), 66 nets.

Other parts of the board:
U$1: XUL-LOGO-8MMH
