oxullo/mml/firmware/mmlmood/variants/mml/variant.h

/*
  Copyright (c) 2014-2015 Arduino LLC.  All right reserved.

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
  You should have received a copy of the GNU Lesser General Public
  License along with this library; if not, write to the Free Software
  Foundation, Inc., 51 Franklin St, Fifth Floor, Boston, MA  02110-1301  USA
*/

#ifndef _VARIANT_MML_
#define _VARIANT_MML_

// The definitions here needs a SAMD core >=1.6.6
#define ARDUINO_SAMD_VARIANT_COMPLIANCE 10606

/*----------------------------------------------------------------------------
 *        Definitions
 *----------------------------------------------------------------------------*/

/** Frequency of the board main oscillator */
#define VARIANT_MAINOSC		(32768ul)

/** Master clock frequency */
#define VARIANT_MCK			  (F_CPU)

/*----------------------------------------------------------------------------
 *        Headers
 *----------------------------------------------------------------------------*/

#include "WVariant.h"

#ifdef __cplusplus
#include "SERCOM.h"
#include "Uart.h"
#endif // __cplusplus

#ifdef __cplusplus
extern "C"
{
#endif // __cplusplus

/*----------------------------------------------------------------------------
 *        Pins
 *----------------------------------------------------------------------------*/

// Number of pins defined in PinDescription array
#define PINS_COUNT           (12u)
#define NUM_DIGITAL_PINS     (7u)
#define NUM_ANALOG_INPUTS    (1u)
#define NUM_ANALOG_OUTPUTS   (1u)
//#define analogInputToDigitalPin(p)  ((p < 6u) ? (p) + 22u : -1)

#define digitalPinToPort(P)        ( &(PORT->Group[g_APinDescription[P].ulPort]) )
#define digitalPinToBitMask(P)     ( 1 << g_APinDescription[P].ulPin )
//#define analogInPinToBit(P)        ( )
#define portOutputRegister(port)   ( &(port->OUT.reg) )
#define portInputRegister(port)    ( &(port->IN.reg) )
#define portModeRegister(port)     ( &(port->DIR.reg) )
#define digitalPinHasPWM(P)        ( g_APinDescription[P].ulPWMChannel != NOT_ON_PWM || g_APinDescription[P].ulTCChannel != NOT_ON_TIMER )


// RX and TX LEDs are not present on the board. 
#define PIN_LED_13           (4u)
#define PIN_LED              PIN_LED_13
#define LED_BUILTIN          PIN_LED_13

#define BUTTON_BUILTIN         (0u)
#define ACCELEROMETER_INT1_PIN (1u)
#define MATRIX_PIN             (2u)
#define HAPTIC_EN_PIN          (3u)

/*
 * Analog pins
 */
#define PIN_A0               (7u)
#define PIN_DAC0             PIN_A0

static const uint8_t A0  = PIN_A0;
static const uint8_t DAC0 = PIN_DAC0;
#define ADC_RESOLUTION		12

/*
 * Serial interfaces
 */

/*
 * SPI Interfaces
 */
#define SPI_INTERFACES_COUNT 0

/*
 * Wire Interfaces
 */

#define WIRE_INTERFACES_COUNT 1

#define PIN_WIRE_SDA         (5u)
#define PIN_WIRE_SCL         (6u)
#define PERIPH_WIRE          sercom1
#define WIRE_IT_HANDLER      SERCOM1_Handler

static const uint8_t SDA = PIN_WIRE_SDA;
static const uint8_t SCL = PIN_WIRE_SCL;

/*
 * I2S Interfaces
 */
#define I2S_INTERFACES_COUNT 0

/*
 * USB
 */
#define PIN_USB_HOST_ENABLE_VALUE   HIGH
#define PIN_USB_DM          (8ul)
#define PIN_USB_DP          (9ul)


#ifdef __cplusplus
}
#endif

/*----------------------------------------------------------------------------
 *        Arduino objects - C++ only
 *----------------------------------------------------------------------------*/

#ifdef __cplusplus

/*	=========================
 *	===== SERCOM DEFINITION
 *	=========================
*/
extern SERCOM sercom0;
extern SERCOM sercom1;
extern SERCOM sercom2;
extern SERCOM sercom3;



#endif

// These serial port names are intended to allow libraries and architecture-neutral
// sketches to automatically default to the correct port name for a particular type
// of use.  For example, a GPS module would normally connect to SERIAL_PORT_HARDWARE_OPEN,
// the first hardware serial port whose RX/TX pins are not dedicated to another use.
//
// SERIAL_PORT_MONITOR        Port which normally prints to the Arduino Serial Monitor
//
// SERIAL_PORT_USBVIRTUAL     Port which is USB virtual serial
//
// SERIAL_PORT_LINUXBRIDGE    Port which connects to a Linux system via Bridge library
//
// SERIAL_PORT_HARDWARE       Hardware serial port, physical RX & TX pins.
//
// SERIAL_PORT_HARDWARE_OPEN  Hardware serial ports which are open for use.  Their RX & TX
//                            pins are NOT connected to anything by default.
#define SERIAL_PORT_USBVIRTUAL      SerialUSB
#define SERIAL_PORT_MONITOR         SerialUSB
#define SERIAL_PORT_HARDWARE        Serial1
#define SERIAL_PORT_HARDWARE_OPEN   Serial1

// The only serial available is the CDC
#define Serial                      SerialUSB


#endif /* _VARIANT_MML_ */
