oxullo/mml/firmware/mmlmood/src/imu.cpp

#include <Arduino.h>

#include "imu.h"


IMU::IMU() :
    tilt_threshold_min(0),
    tilt_threshold_max(0),
    last_orientation(IMU::ORIENTATION_UNKNOWN)
{
}


void IMU::begin(float tilt_threshold_min, float tilt_threshold_max)
{
    this->tilt_threshold_min = tilt_threshold_min;
    this->tilt_threshold_max = tilt_threshold_max;
    accelerometer.begin();
}

// Returns ORIENTATION_UNKNOWN when no orientation change is detected
IMU::Orientation IMU::update()
{
    if (accelerometer.is_data_ready()) {
        accelerometer.read();
        IMU::Orientation current_orientation = evaluate_orientation();

        if (current_orientation != IMU::ORIENTATION_UNKNOWN &&
                current_orientation != last_orientation) {
            last_orientation = current_orientation;

            return current_orientation;
        }
    }

    return IMU::ORIENTATION_UNKNOWN;
}

IMU::Orientation IMU::evaluate_orientation()
{
    IMU::Orientation candidate = IMU::ORIENTATION_UNKNOWN;

    if (abs(accelerometer.norm().z) < tilt_threshold_min) {
        if (abs(accelerometer.norm().x) < tilt_threshold_min) {
            if (accelerometer.norm().y > tilt_threshold_max) {
                candidate = IMU::ORIENTATION_VERTICAL_NORMAL;
            } else if (accelerometer.norm().y < -tilt_threshold_max) {
                candidate = IMU::ORIENTATION_VERTICAL_180;
            }
        } else if (abs(accelerometer.norm().y) < tilt_threshold_min) {
            if (accelerometer.norm().x > tilt_threshold_max) {
                candidate = IMU::ORIENTATION_VERTICAL_90CW;
            } else if (accelerometer.norm().x < -tilt_threshold_max) {
                candidate = IMU::ORIENTATION_VERTICAL_90CCW;
            }
        }
    } else {
        if (accelerometer.norm().z > tilt_threshold_max) {
            candidate = IMU::ORIENTATION_HORIZONTAL_BOTTOM;
        } else if (accelerometer.norm().z < -tilt_threshold_max) {
            candidate = IMU::ORIENTATION_HORIZONTAL_TOP;
        }
    }

    if (orientation_counters[candidate] < COUNT_THRESHOLD + COUNT_HYSTERESIS) {
        ++orientation_counters[candidate];
    }

    IMU::Orientation detected = IMU::ORIENTATION_UNKNOWN;
    for (uint8_t i=0 ; i < IMU::MAX_ORIENTATIONS ; ++i) {
        if (i != candidate && orientation_counters[i] != 0) {
            --orientation_counters[i];
        }

        // TODO: invalidate when more than one counter asserts
        if (orientation_counters[i] > COUNT_THRESHOLD) {
            detected = (IMU::Orientation)i;
        }
    }

    return detected;
}

IMU imu;
