oxullo/mml/(commit log)

2021-10-18 Initial import for revision A
    [mml_matrix.brd, mml_matrix.sch, mml_mcu.brd, mml_mcu.sch]
2021-10-18 Add production files for revision A
    [mml_matrix v14_top_bom.csv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]
2021-10-18 Add implementation test for the accelerometer
2021-10-18 Add a minimal test for the haptic driver
2021-10-23 Add blink experiment
    [arduino_zero.cfg]
2021-10-23 Add i2c scanner
    [arduino_zero.cfg]
2021-10-23 Adapt VEML7700 test for MML
    [arduino_zero.cfg]
2021-10-23 Add a matrix test
    [arduino_zero.cfg]
2021-10-24 Adapt for mml and fix missing wire init
    [arduino_zero.cfg]
2021-10-25 Add board bootloader
2021-10-25 Initial import of the firmware
    [arduino_zero.cfg]
2021-10-25 Integrate haptic driver
2021-10-25 Switch tilt thresholds to normalised coordinates
2021-11-15 MCU board revision B
    [mml_mcu.brd, mml_mcu.sch]
